DM3YAB/BatteryCharger_12V/Hardware/Schematic/WoMo-SolarMainCharge_Display-Schematic.pdf

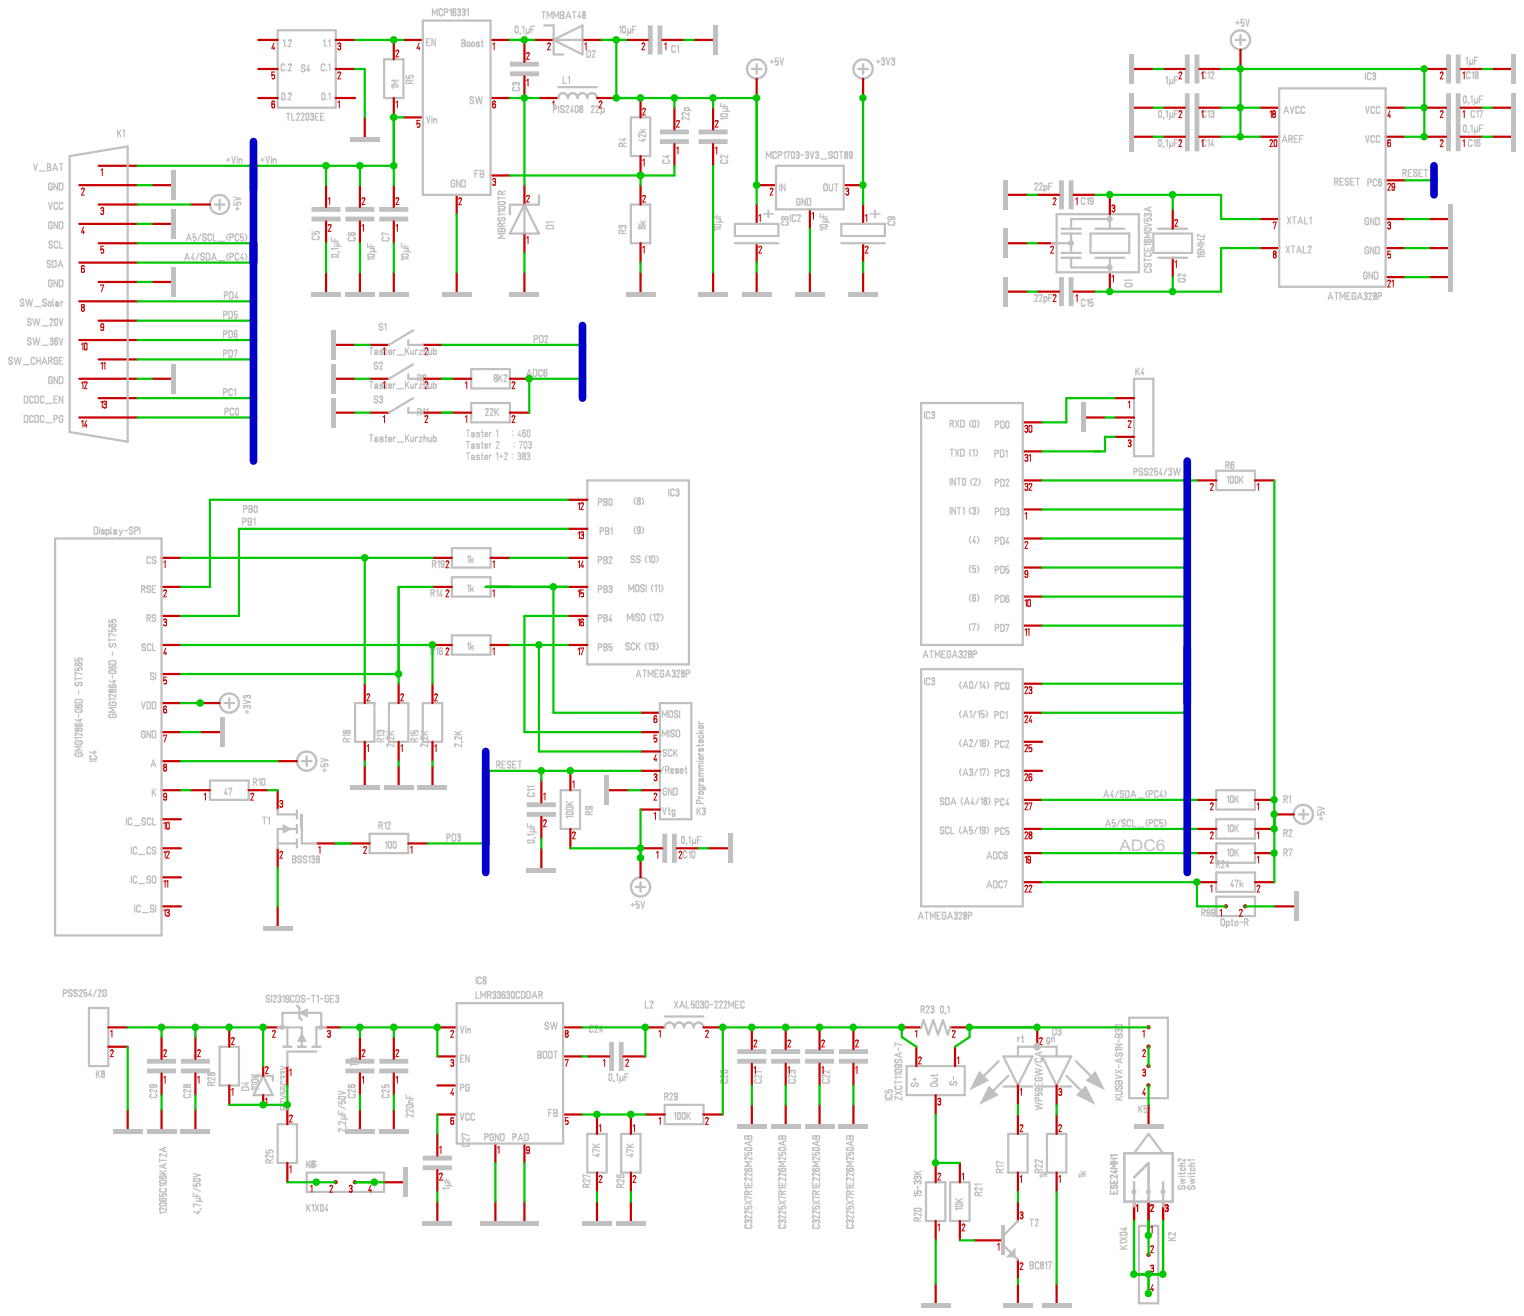
[picture p1: page 1]
ADC6
