DM3YAB/BatteryCharger_12V/Hardware/Schematic/WoMo-SolarMainCharge_Schematic.pdf

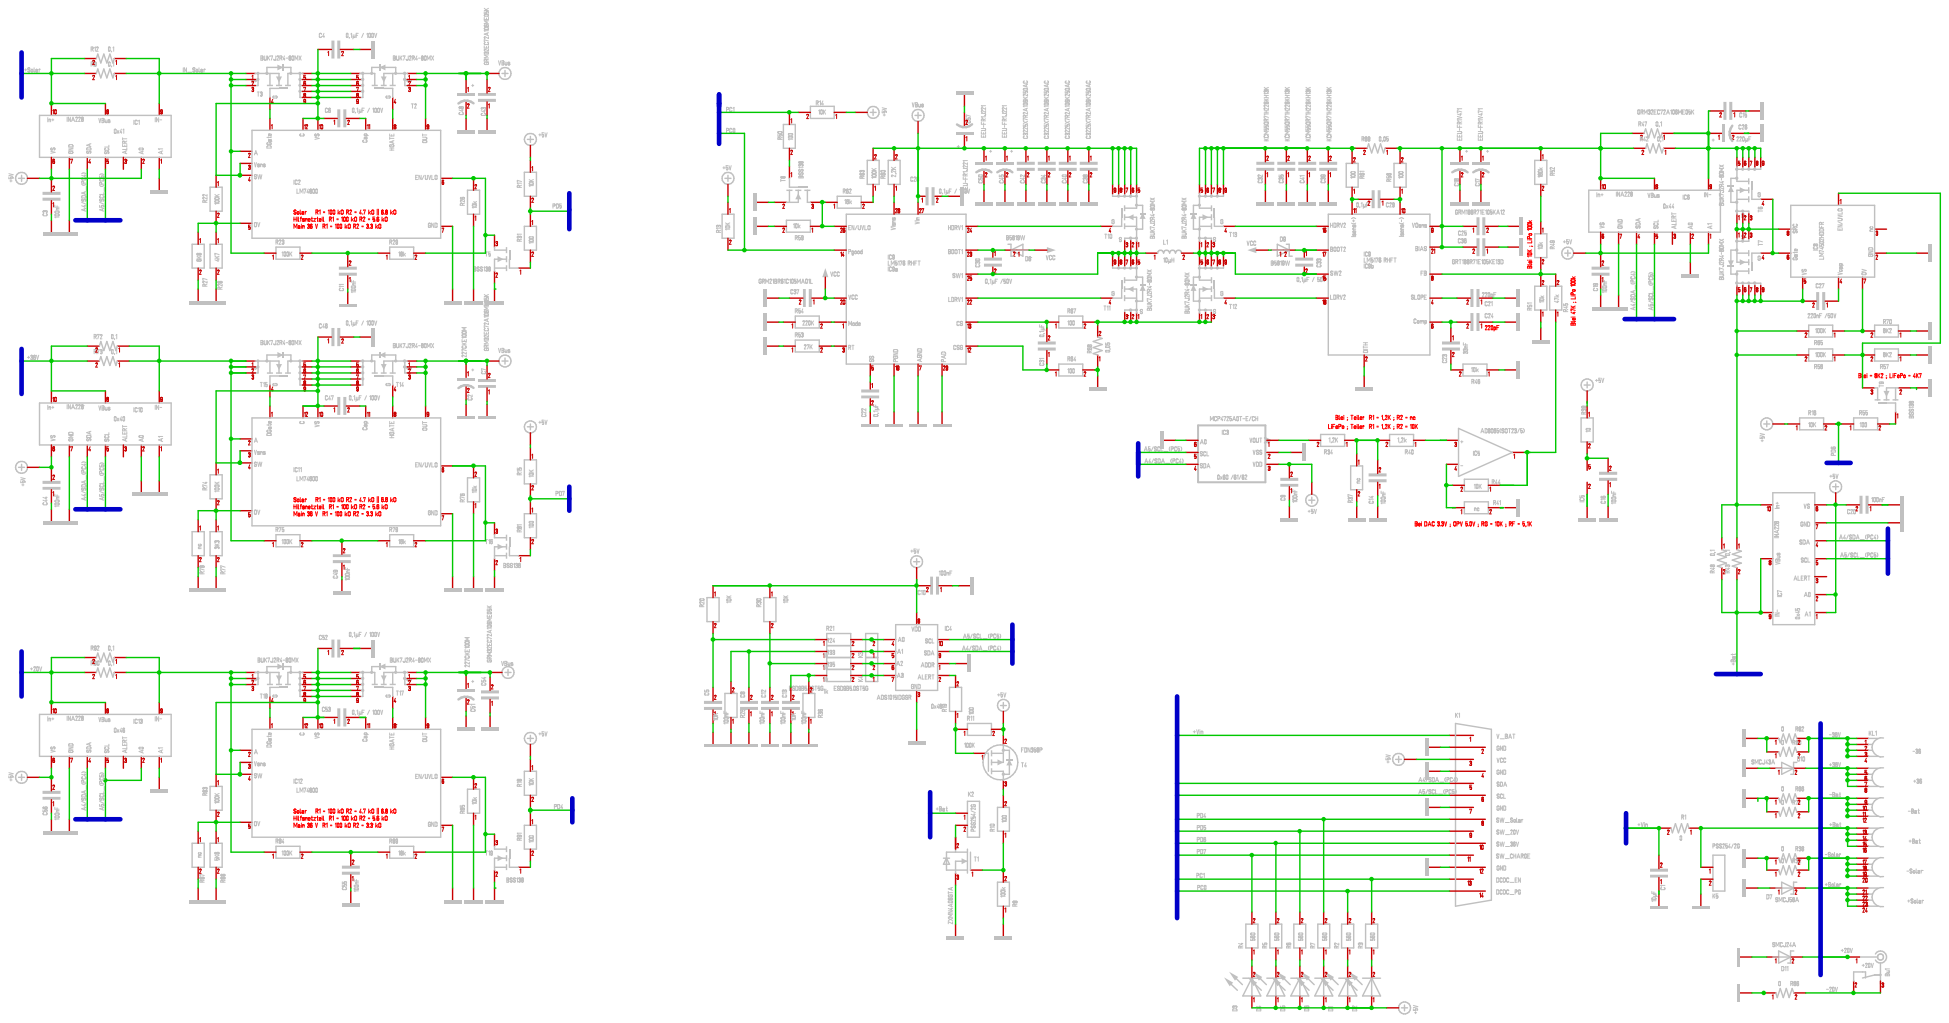
[picture p2: page 1]
