DM3YAB/BatteryCharger_12V/Hardware/PCB/WoMo-SolarMainCharge_Display-PCB-Bottom.pdf

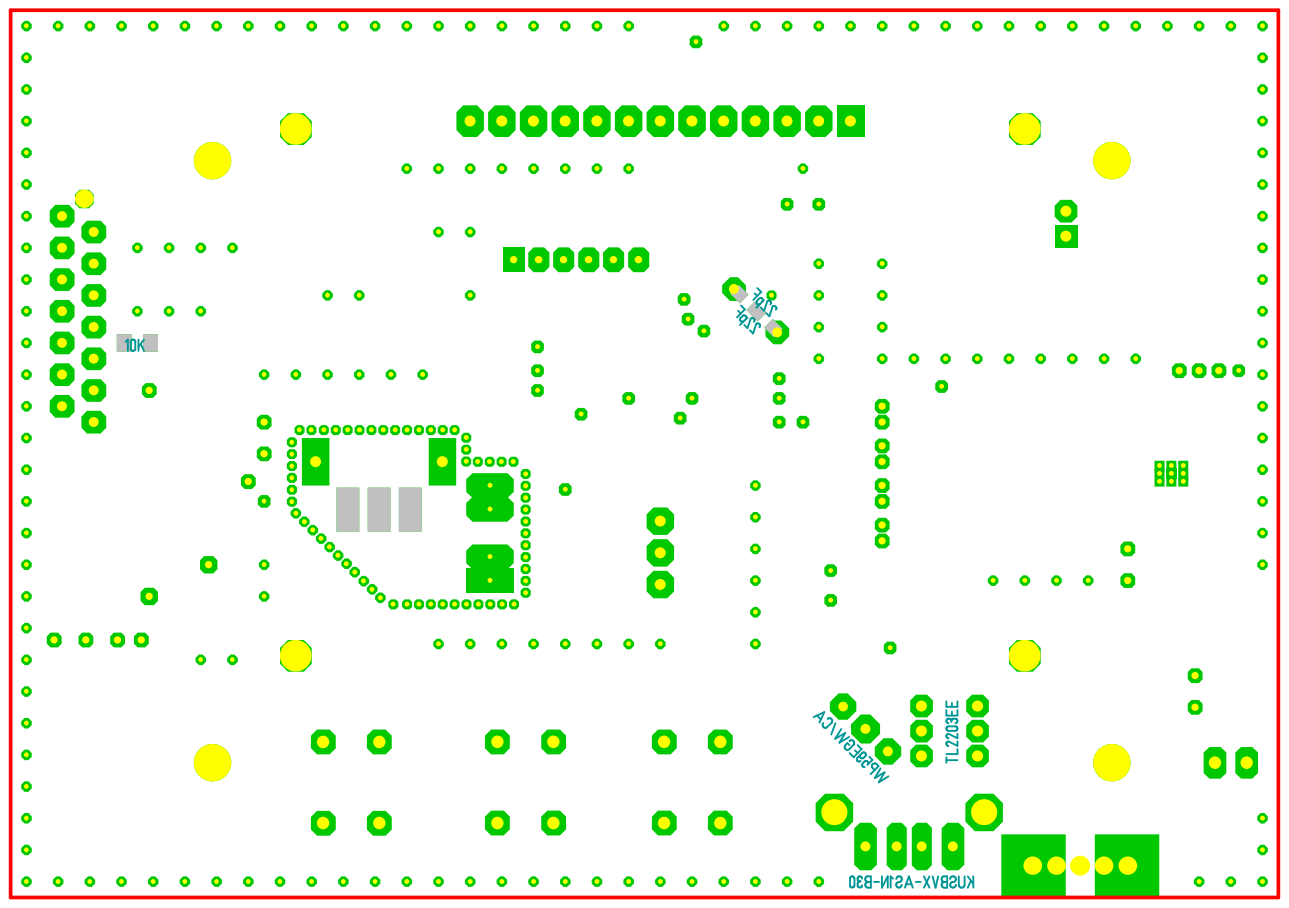
[picture p3: page 1]
