DM3YAB/BatteryCharger_12V/Hardware/PCB/WoMo-SolarMainCharge_Display-PCB-TOP.pdf

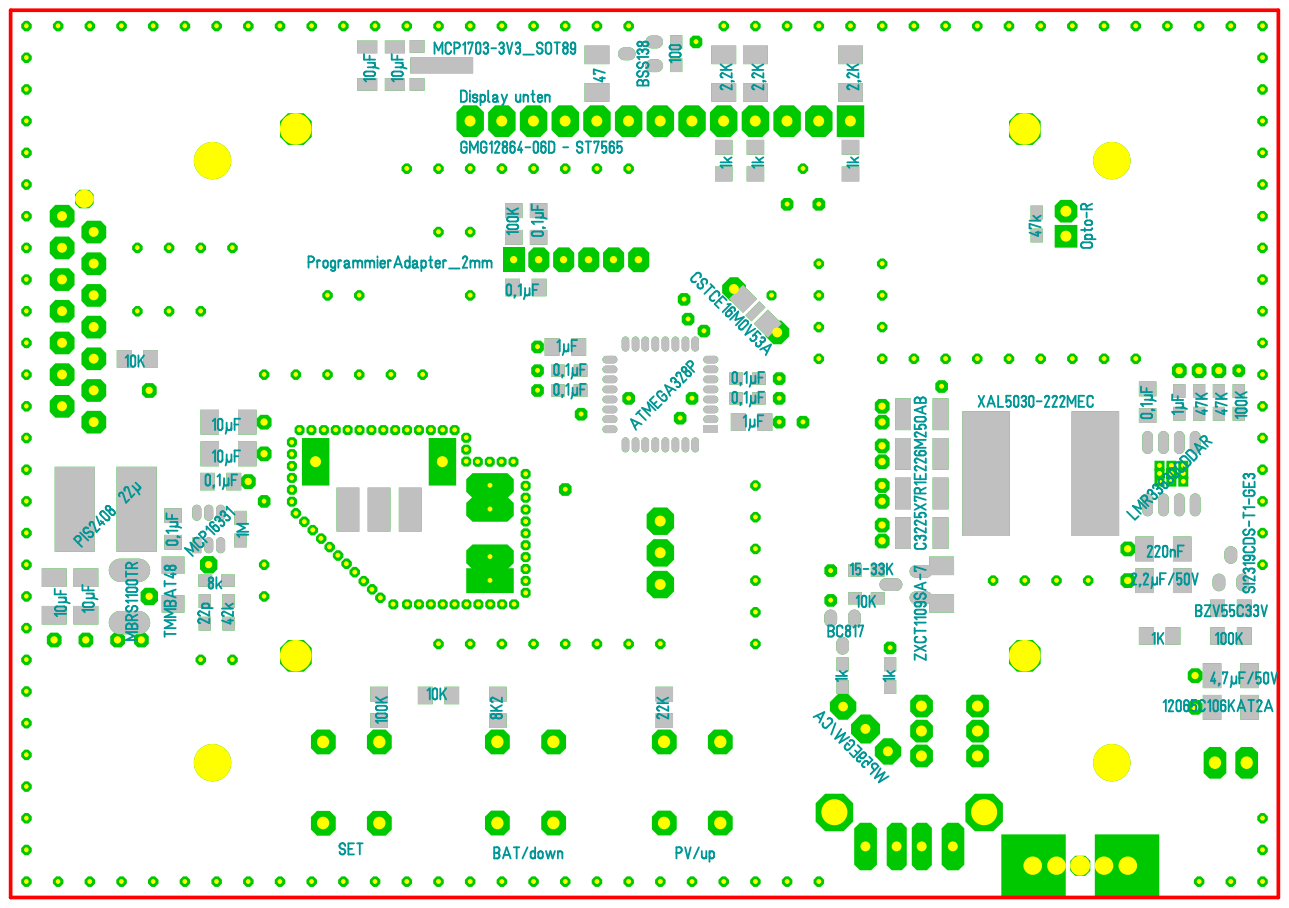
[picture p4: page 1]
