DM3YAB/BatteryCharger_12V/Hardware/Schematic/WoMo-SolarMainCharge-PCB-Bottom.pdf

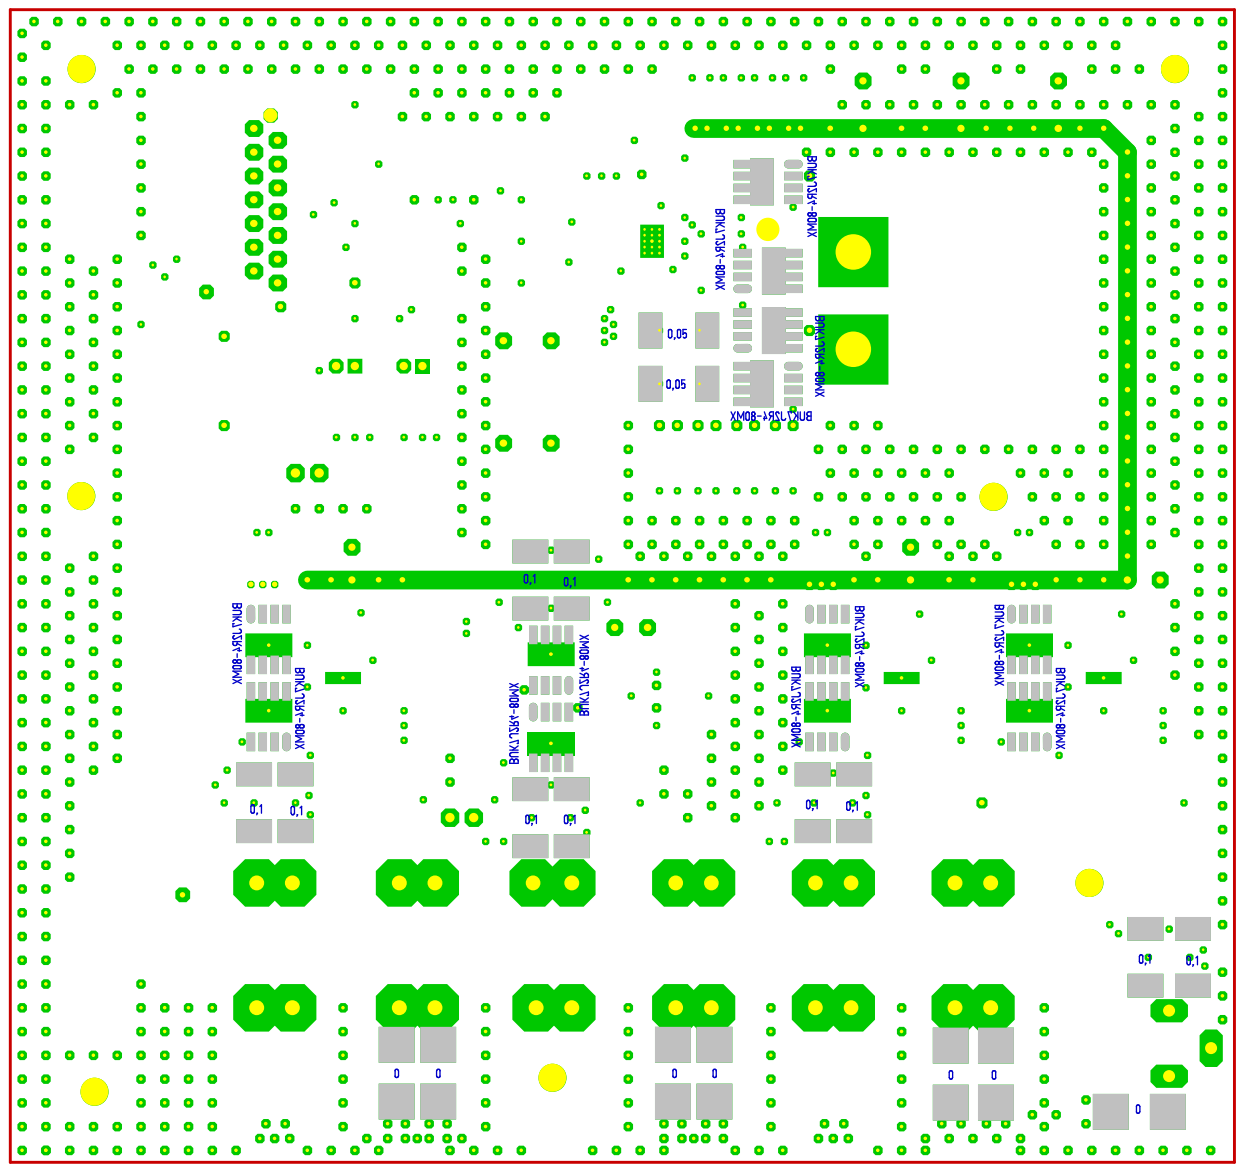
[picture p5: page 1]
