DM3YAB/BatteryCharger_12V/Hardware/Schematic/WoMo-SolarMainCharge-PCB-TOP.pdf

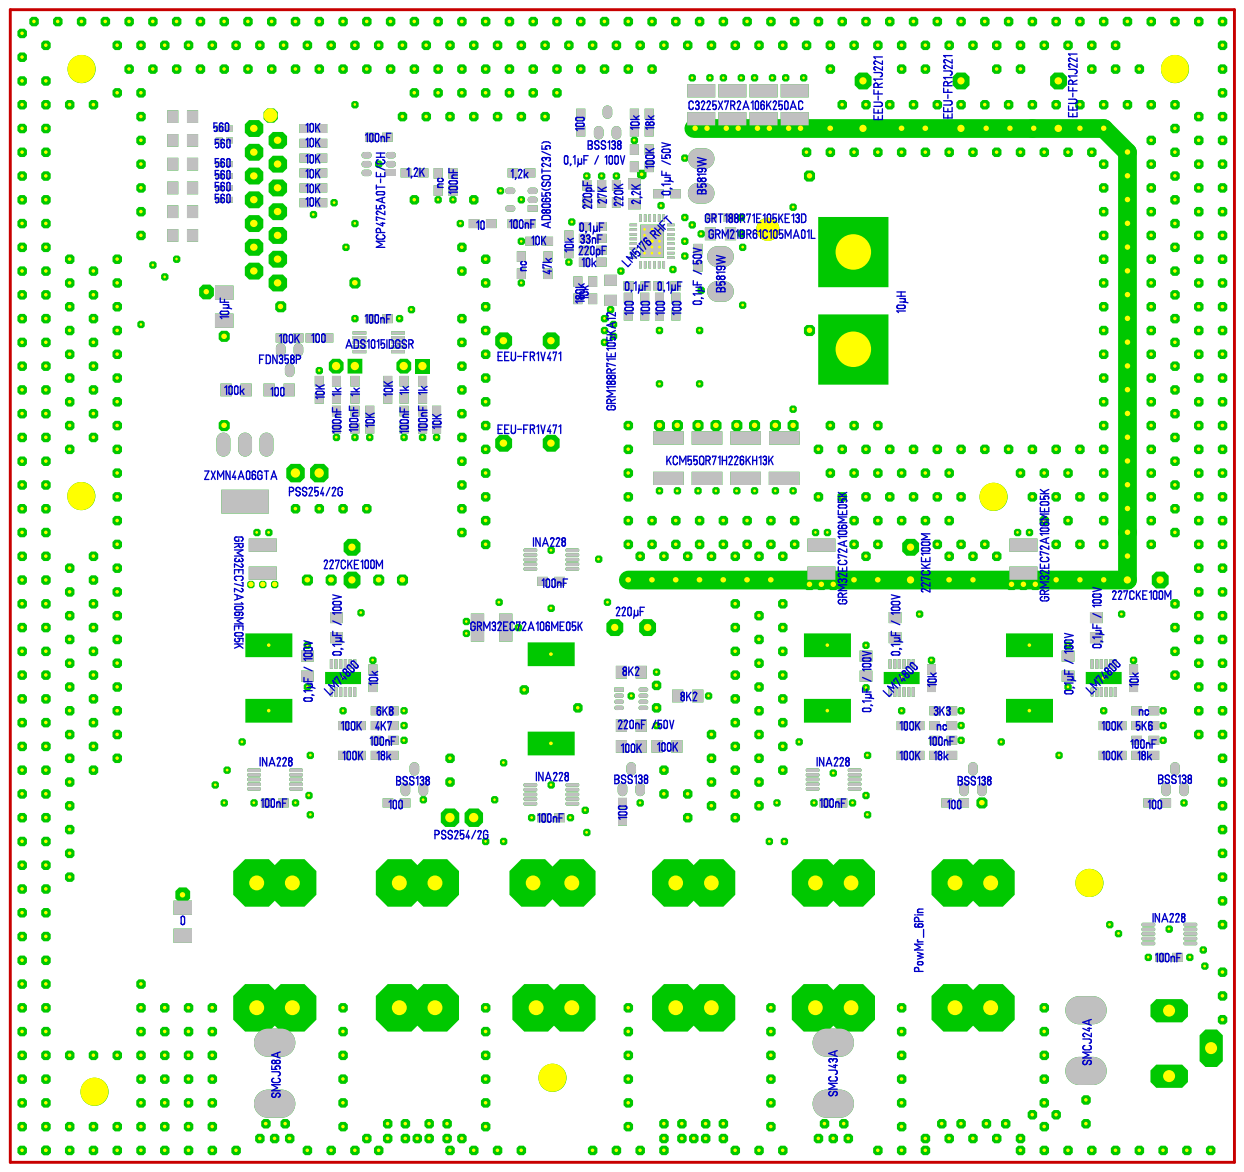
[picture p6: page 1]
